ekolker/6LoWPAN-target/README.md

**[UNMAINTAINED] This library does not have a maintainer. The source code and repository will be kept at this URL indefinitely. If you'd like to help maintain this codebase, create an issue on this repo explaining why you'd like to become a maintainer and tag @tessel/maintainers in the body.**

6LoWPAN-target
==============

A [6LoWPAN](http://en.wikipedia.org/wiki/6LoWPAN) target with a Tessel module port.

Designs in KiCad.

### License

Copyright 2014 Technical Machine, Inc.

CC-BY-SA
