ekolker/6LoWPAN-target/6lp/6lp-target.pdf

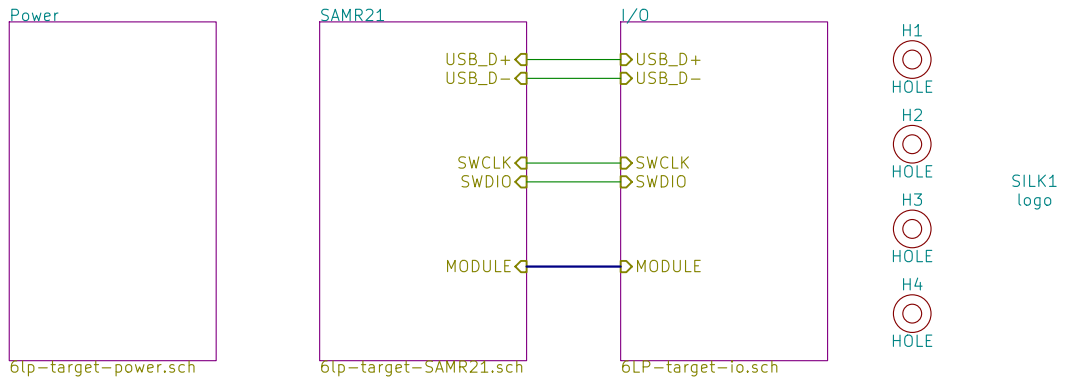
[picture p1: page 1]

File: 6lp.sch Sheet: / Technical Machine Copyright 2014 Technical Machine, Inc. CC-BY-SA Power 6lp-target-power.sch

Id: 1/4 Title: Tessel 6LoWPAN target

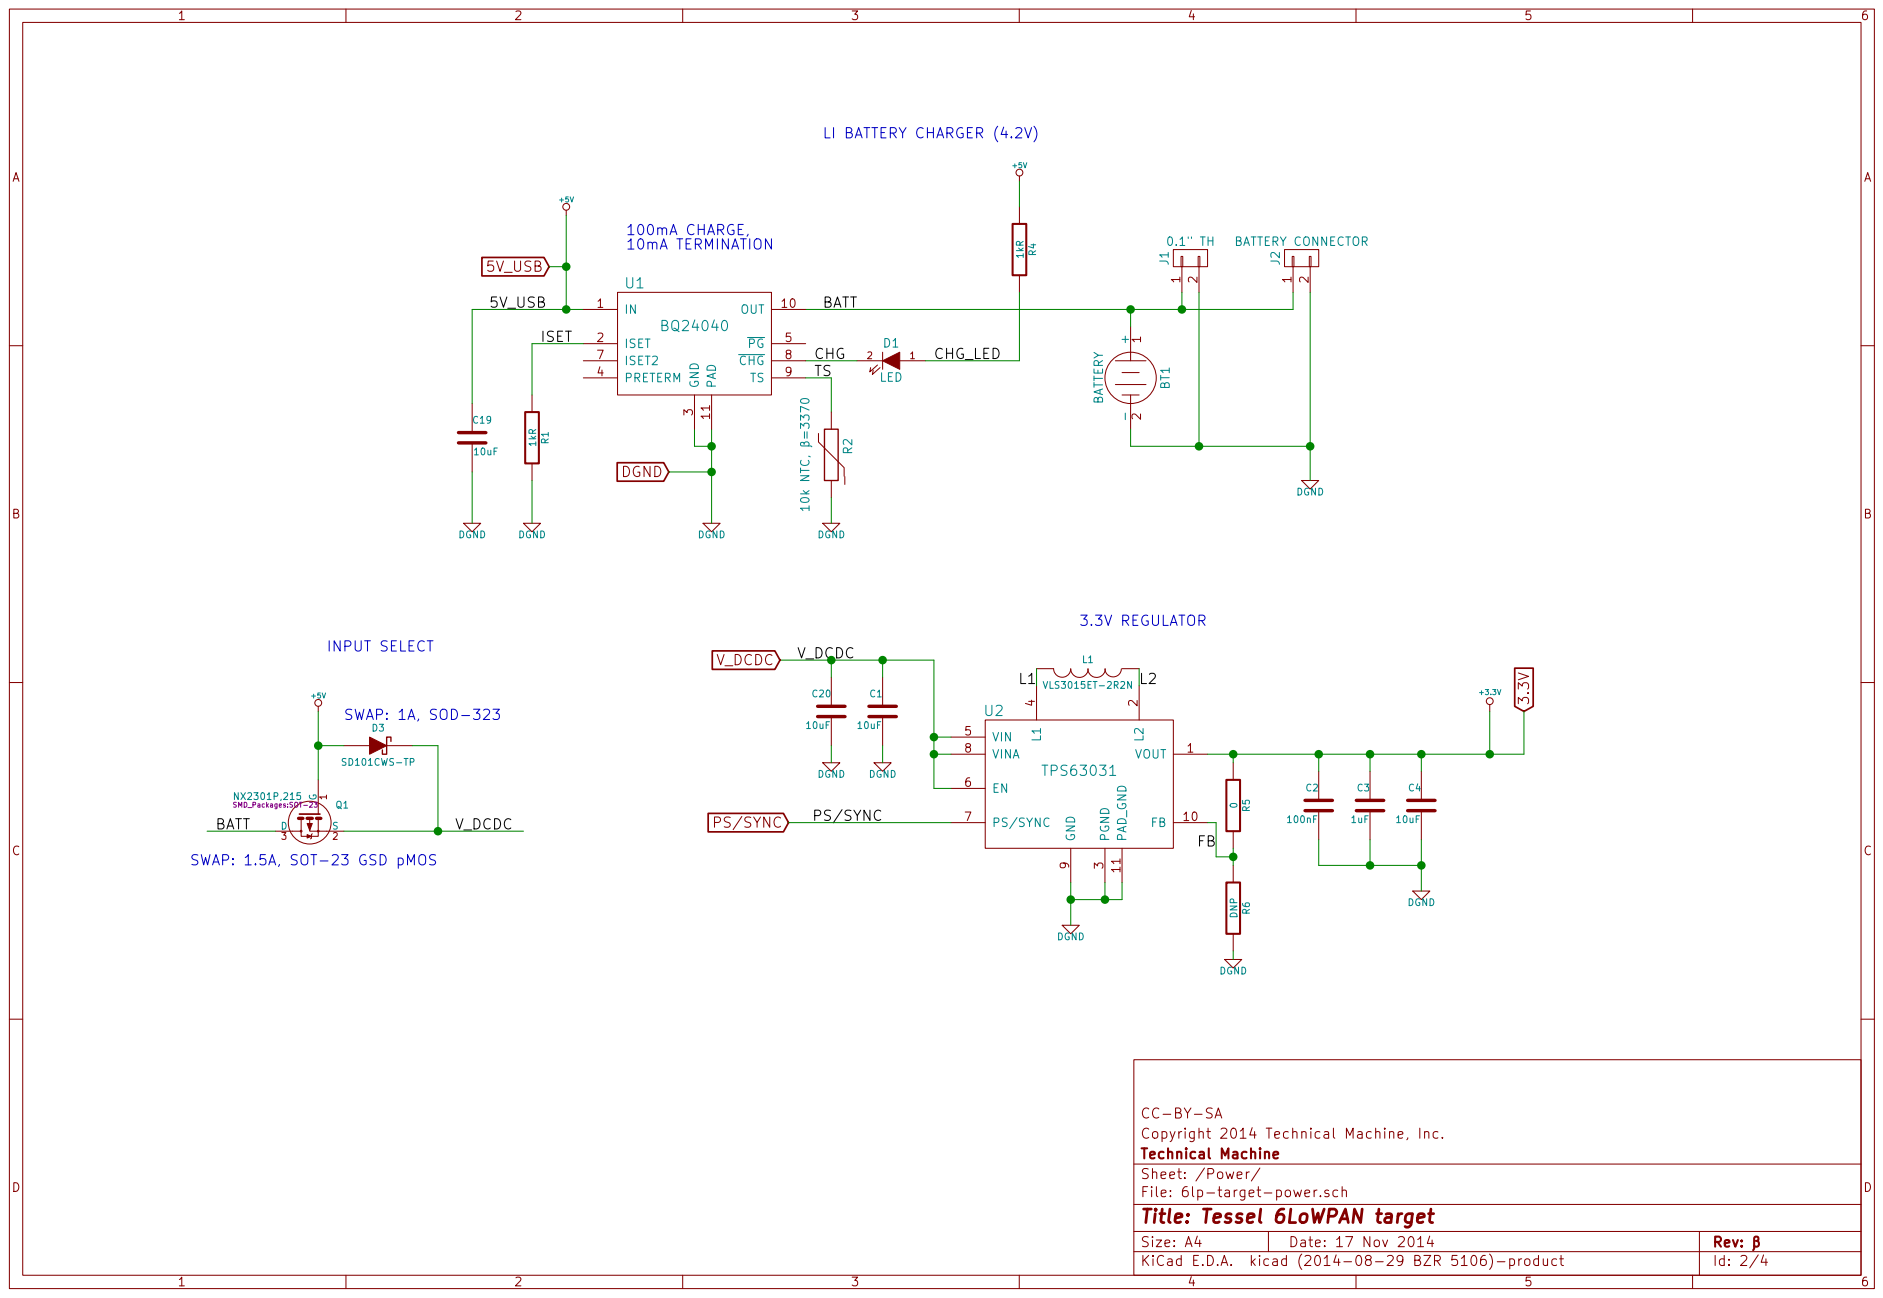
[picture p2: page 2]

2 J2 BATTERY CONNECTOR PS/SYNC

- R2 10k NTC, =3370 DGND 1kRR1 DGND TS

4 VIN 5 EN 6 PS/SYNC 7 VINA 8 GND

SWAP: 1.5A, SOT-23 GSD pMOS

Id: 2/4 Title: Tessel 6LoWPAN target

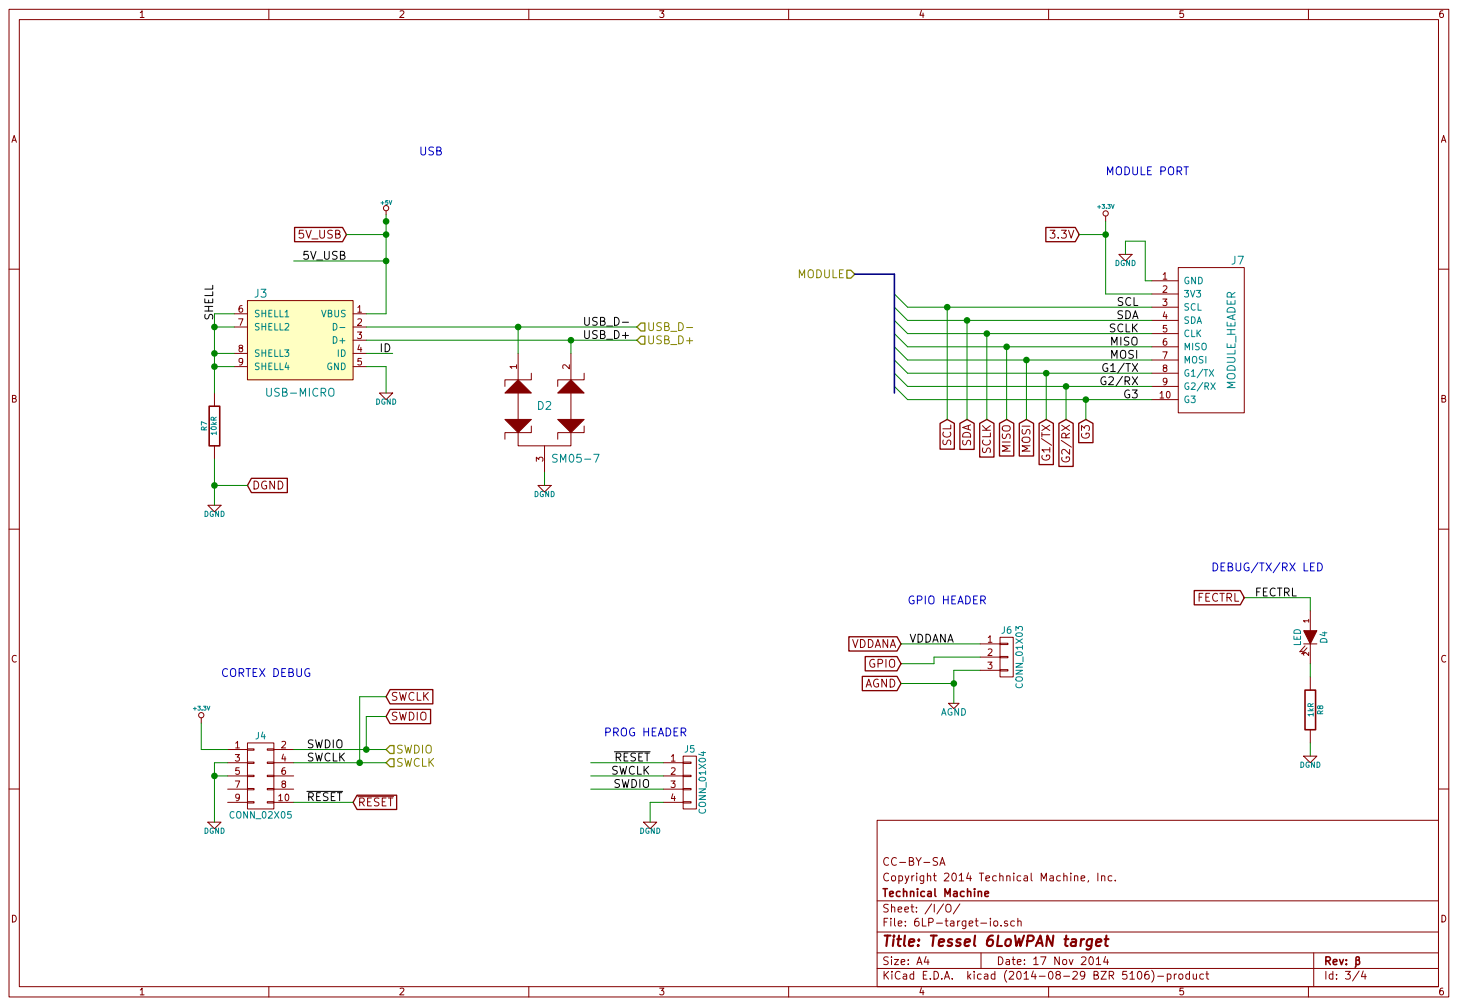
[picture p3: page 3]

MISO

MOSI AGND VDDANA GPIO HEADER

G1/TX
G2/RX
G3

DEBUG/TX/RX LED

File: 6LP-target-io.sch Sheet: /I/O/ Technical Machine Copyright 2014 Technical Machine, Inc. CC-BY-SA

Id: 3/4 Title: Tessel 6LoWPAN target

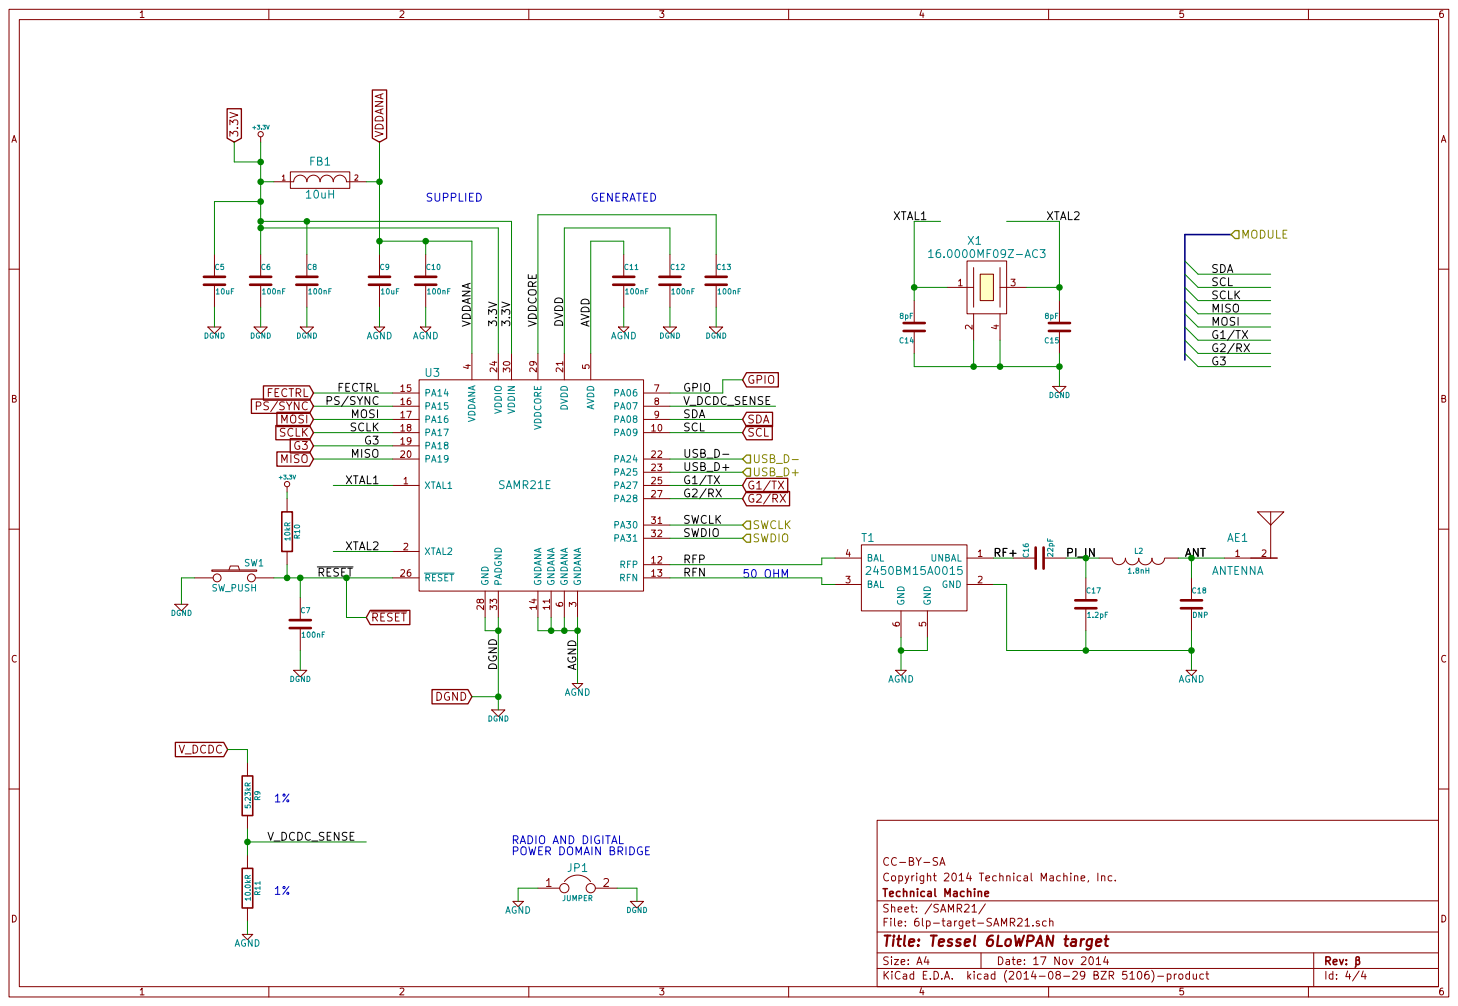
[picture p4: page 4]

6 PA06 7 PA07 8 PA08 9 PA09 10 PA19 20 VDDIN 30 GNDANA 11 DVDD 21 PA30 31 RFP 12 PA24 22 PA31 32 RFN 13 PA25 23 PADGND 33 GNDANA 14 VDDIO 24 PA14 15 PA27 25 PA15 16 RESET 26 PA16 17 PA28 27 PA17 18 GND 28 PA18 19 VDDCORE 29 U3 SAMR21E
MOSI XTAL1 XTAL2G3
SCLK

SWDIO
C18 DNP RF+ RFP RFN

File: 6lp-target-SAMR21.sch Sheet: /SAMR21/ Technical Machine Copyright 2014 Technical Machine, Inc. CC-BY-SA

Id: 4/4 Title: Tessel 6LoWPAN target
