ekolker/6LoWPAN-target/(commit log)

2014-10-03 created kicad project
2014-10-03 power domain in sch
    [6lp.sch]
2014-10-04 first pass schematic
    [6lp.sch]
2014-10-14 added usb, part associations
    [6lp.sch]
2014-10-17 switch to appropriate readme
2014-10-22 about to do the pin muxing
    [6lp.sch]
2014-10-22 pins mux'd!
    [6lp.sch]
2014-10-23 added regulator, completely reorganized into sheets
    [6LP-target-io.sch, 6lp-target-SAMR21.sch, 6lp-target-power.sch, 6lp.sch]
2014-10-24 proper pix muxing
    [6LP-target-io.sch, 6lp-target-SAMR21.sch, 6lp-target-power.sch, 6lp.sch]
2014-10-24 redid annotation so the refdes aren't HUGE
    [6LP-target-io.sch, 6lp-target-SAMR21.sch, 6lp-target-power.sch]
2014-10-24 component file is ready...i hope
    [6LP-target-io.sch, 6lp-target-SAMR21.sch, 6lp-target-power.sch]
2014-10-24 i has a board! it has a lot of parts!
    [6LP-target-io.sch, 6lp-target-SAMR21.sch, 6lp-target-power.sch, 6lp.kicad_pcb, 6lp.sch]
2014-10-24 pcb work...also labels did not work how i thought they did :/
    [6LP-target-io.sch, 6lp-target-SAMR21.sch, 6lp-target-power.sch, 6lp.kicad_pcb, 6lp.sch]
2014-10-30 layout passes drc
    [6LP-target-io.sch, 6lp-target-SAMR21.sch, 6lp-target-power.sch, 6lp.kicad_pcb]
2014-10-30 changes w/ schem, layout review. passes drc.
    [6LP-target-io.sch, 6lp-target-SAMR21.sch, 6lp-target-power.sch, 6lp.kicad_pcb]
2014-10-30 added a logo, passes drc
    [6lp.kicad_pcb, 6lp.sch]
2014-10-30 silk optimization, impedance matching
    [6lp.kicad_pcb, 6lp.sch]
2014-10-30 gerber zip, saved and closed project
2014-10-31 power select circuitry
    [6LP-target-io.sch, 6lp-target-SAMR21.sch, 6lp-target-power.sch, 6lp.sch]
2014-10-31 gpio rehash, netlist and component update
    [6LP-target-io.sch, 6lp-target-SAMR21.sch, 6lp-target-power.sch, 6lp.sch]
2014-10-31 don't sass me, DRC
    [6LP-target-io.sch, 6lp-target-SAMR21.sch, 6lp-target-power.sch, 6lp.kicad_pcb]
2014-11-01 silk optimization
    [6lp.kicad_pcb]
2014-11-05 let's make a board!
    [6LP-target-io.sch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]
2014-11-12 end of version alpha
    [6lp.kicad_pcb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]
2014-11-12 swap to cortex debug on schem
    [6LP-target-io.sch]
2014-11-12 cortex debug to pcb
    [6lp.kicad_pcb]
2014-11-15 swapped chargers to bq24040
    [6LP-target-io.sch, 6lp-target-SAMR21.sch, 6lp-target-power.sch, 6lp.kicad_pcb, 6lp.sch]
2014-11-15 stupid thing switched out the uUSB symbol on me...
    [6LP-target-io.sch, 6lp.kicad_pcb]
2014-11-15 preliminary placement of new batt circuitry
    [6LP-target-io.sch, 6lp-target-power.sch, 6lp.kicad_pcb]
2014-11-17 rev 2
    [6lp-target-power.sch, 6lp.kicad_pcb]
2014-11-17 new gerbers
    [6lp-B_Cu.gbr, 6lp-B_Mask.gbr, 6lp-B_SilkS.gbr, 6lp-Edge_Cuts.gbr, 6lp-F_Cu.gbr, 6lp-F_Mask.gbr, 6lp-F_Paste.gbr, 6lp-F_SilkS.gbr]
2014-11-17 passes 7mil drc. building a board!
    [6lp.kicad_pcb]
2014-11-17 silk is better now. actually making this one...i think.
    [6lp-B_Cu.gbr, 6lp-B_Mask.gbr, 6lp-B_SilkS.gbr, 6lp-Edge_Cuts.gbr, 6lp-F_Cu.gbr, 6lp-F_Mask.gbr, 6lp-F_Paste.gbr, 6lp-F_SilkS.gbr]
2014-11-17 schematic pdf
2014-11-17 this just in: always explicitly save your sub-schematics
    [6LP-target-io.sch, 6lp-target-SAMR21.sch, 6lp-target-power.sch, 6lp.sch]
2014-12-12 just in case, we can add the cache library
    [6lp-bom.csv]
